jarodlam/surf-rescue-boat/report/vres-report.pdf

# Autonomous surf life saving device

## Jarod Lam

## Supervisor: Matthew Dunbabin

2018-2019 VRES project at Queensland University of Technology

CONTENTS

I | Introduction | 2
II | Boat | 2
II-A | Mechanical | | 2
II-A1 | Chassis | | 2
II-A2 | Propellors | | 2
II-A3 | Electronics housing | | 2
II-B | Electronics | | 2
II-B1 | Microcontroller | | 2
II-B2 | Radio | | 2
II-B3 | GPS | | 2
II-B4 | Orientation | | 3
II-B5 | Motor control | | 3
II-B6 | Battery | | 3
II-C | Software | | 3
II-C1 | srb | | | 3
II-C2 | nmea | | 3
II-C3 | srb_stats | | 3
II-C4 | srb_serial | | 3
II-C5 | srb_gps | | 3
II-C6 | srb_comms | | 3
II-C7 | srb_imu | | 3
II-C8 | srb_motor | | 3
II-C9 | srb_nav | | 3
III | Communications | 4
III-A | NMEA 0183 protocol | | 4
III-B | Proprietary NMEA sentences | | 4
III-B1 | SRBSM - Status Message . . | 4
III-B2 | SRBJS - Joystick | | 4
III-B3 | SRBWP - Waypoint | | 4
IV | Testing | 4
V | Future development | 4
References | 4
Appendix A: Code | | | 5
A-A | the codes | | 5
Appendix B: Drawings | | | 5
B-A | the drawings | | 5
Abstract—build boat that saves people
I. INTRODUCTION
Surf life savers regularly patrol popular beaches to help those in danger, but there is a limit to the speed and ability of a human swimmer.
To supplement the activities of surf life savers at public beaches, a system has been proposed that will allow timely help to be given to people in danger while they wait to be rescued. The surf rescue boat (SRB) aims to deliver help quickly and reduce the risk to which life savers are exposed. A simple water-based robot such as the one proposed can be constructed relatively cheaply and easily with off-the-shelf components. In the future, systems such as these may become widely available and save the lives of many along our coastal beaches. A prototype of one such robot was designed and built over the course of this project.
The system is divided into three main sections: a remotely operated water vehicle (the ”boat”), an XBee-based radio communications system and protocol, and shoreline control. Out of these, only the vehicle and communications were pro-totyped in this project; the control system has been developed separately in the past and time constraints prevented it from being implemented.
This report describes these systems in detail, the design methodology, and avenues that can be explored for future development of the surf rescue boat.

II. BOAT

A. Mechanical

The remotely operated boat uses a standard surfboard as a base, and houses electronics in a watertight hard plastic case attached to the top. Two propellers are mounted to the bottom of the surfboard for movement control.
1) Chassis: Surfboard. Chosen for its stability and familiar-ity in the surf. The standardness and availability of surfboards is an advantage to encouraging development of such systems. A custom-built chassis may have been designed, but would have taken more time and money.
2) Propellors: 2 Blue Robotics T100 Thrusters. A propeller is mounted each to the left and right of the surfboard’s middle underside. Aluminium mounting plates, attached to the board with Sikaflex, were designed to distribute force and allow propellors to be detached easily.
3) Electronics housing: Pelican 1120 Case. A laser-cut acrylic frame was made to mount the electronics in the box. Wire glands on the side of the box allow propellor wires to be fed through the box walls.
B. Electronics

An Arduino Mega 2560 controls the onboard electronics mounted in the case. GPS and IMU modules are used for navigation, and an XBee radio communicates with the base station. A block connection diagram of the electronics is shown in Figure 1.
1) Microcontroller: Arduino Mega 2560 with Seeedstudio Grove Mega Shield breakout board. This development board is powerful enough to handle relatively simple communication and processing tasks required to control the boat’s sensors and motors. More powerful ARM-based boards such as the Raspberry Pi are less suited to rugged environments, and more difficult to recover from failures. The shield provides robust headers to the UART functions of the Arduino.
2) Radio: Digi XBee Pro S1 on a SparkFun XBee Explorer Regulated. This connects to the Arduino via UART, and creates a wireless serial connection to the base station. The protocol is defined in section 3.
3) GPS: LOCOSYS LS20031 GPS receiver. Sends data to the Arduino via UART using the NMEA 0183 protocol found in section 3.

11.1V

UART
UART

UART

PWM

Arduino Mega

Battery 1

Battery 2

ESC 1

ESC 2

XBee

GPS | IMU

Fig. 1. Connection block diagram for onboard electronics.

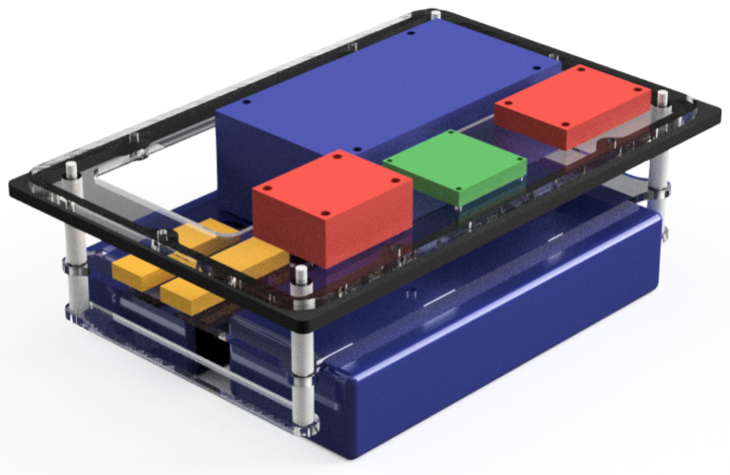
[picture p9: figure]

Fig. 2. Rendering of internal electronics frame

4) Orientation: Sparkfun SEN-10736 9DOF Razor IMU. Sends data to the Arduino via UART. Currently, only the compass value from the sensor is used. Flashed with the Razor AHRS firmware: https://github.com/Razor-AHRS/razor-9dof-ahrs
5) Motor control: 2 Flycolor Raptor 390 30A ESC. Firmware modified to allow forward and backward propeller movement. Receives PWM control signals from the Arduino with a duty cycle range of 1000 µs to 2000 µs.
6) Battery: 2 Zippy Flightmax Z58003S-30 5800 mAh 3S1P. The two batteries are wired in parallel, with a combined nominal capacity of 11.6 Ah and nominal voltage of 11.1 V.
C. Software
The Arduino Mega 2560 is programmed in C++ on top of Arduino default and custom libraries. Efforts were made to keep the code somewhat portable and reusable.
The code is split up into several modules, each handling a section of robot operation. These are described below, and the full code can be found in appendix A.
1) srb: Contains the main loop of the program. Initialises values, classes, etc. Runs update functions for GPS, comms, IMU, nav, and motors. Sends SRBSM message at intervals. An AVR watchdog timer is set to reset the microcontroller at the hardware level if the program hangs and reaches a timeout.
2) nmea: Defines the Nmea class, which contains functions for constructing and parsing NMEA 0183 sentences. This includes generating and validating checksums, counting the number of fields, appending strings and decimal numbers to a sentence, and parsing a sentence by field. All functions use standard C string libraries, so they do not rely on Arduino libraries and will work outside the Arduino environment. Used
by SrbGps and SrbComms.
3) srb_stats: Defines the SrbStats class, which stores the ID, state, GPS and target location, compass and target heading, and other information related to the current state and navigation of the boat. A pointer to the same instance of this class is passed to most other classes when they are created so that they can read and update this information.
4) srb_serial: Defines the SrbSerial class, which buffers a hardware serial stream and parses the input when a newline is received. The serial port used is configured when the object is created. This is the base class for SrbGps,
SrbComms, and SrbImu.
5) srb_gps: Defines the SrbGps class, which receives and parses GPS fix data over serial. Latitude, longitude, magnetic variation, and ground speed are parsed from the NMEA GPRMC sentence and stored in the SrbStats object. Conversions are made from knots to metres per second, and degrees/minutes to decimal degrees.
6) srb_comms: Defines the SrbComms class, which sends and receives messages to and from the base station via the XBee radio. Contains functions for constructing and parsing the proprietary NMEA sentences defined in section 3. Stores information and instructions received in the SrbStats object. Stops the boat if no message is received within a timeout period.
7) srb_imu: Defines the SrbImu class, which receives data from the Sparkfun IMU over serial. Extracts the compass heading from the serial stream and stores it in the SrbStats object.
8) srb_motor: Defines the SrbMotor class, which controls motor movement. Receives motor power ranges from -100 to 100 and sets the corresponding PWM duty cycle. Accelerates motors to the desired speed at a safe pace.
9) srb_nav: Defines the SrbNav class, which controls robot navigation. In manual mode, sets motor speed and orients the boat according to target speed and heading sent from the base station. In auto mode, moves the boat toward a set of coordinates sent from the base station. Motors are controlled with the SrbMotor class.

III. COMMUNICATIONS

Communications between the SRB and the base station are done using XBee radios. By attaching a pair of XBee modules to the base station computer and the on-board Arduino, a virtual serial connection is effectively created between the two devices.

A. NMEA 0183 protocol

NMEA 0183 is a communications specification designed to create a standardised serial interface for GPS devices. Every NMEA ‘sentence’ begins with a $ and ends with *CS\r\n, where CS is a two-digit hexadecimal checksum of the sentence.
A common NMEA sentence type is GPRMC, the GPS recommended minimum. GPRMC sentences are specified as follows: [1]

$GPRMC,<Time>,<Status>,<Lat>,<LatDir>, <Lon>,<LonDir>,<Speed>,<Angle>,<Date>, <MagVar>,<MagDir>*CS

Where:
<Time> | UTC timestamp in HHmmss format
<Status> | Status A=active, V=void
<Lat> | Latitude in ddmm.mmm format
<LatDir> | N or S hemisphere
<Lon> | Longitude in dddmm.mmm format
<LonDir> | E or W hemisphere
<Speed> | Ground speed in knots
<Angle> | Track angle in degrees from north
<Date> | Date in DDMMYY format
<MagVar> | Magnetic variation magnitude
<MagDir> | Magnetic variation direction

A NMEA sentence parser was written for the SRB to interpret messages from the on-board GPS and extract location information.

B. Proprietary NMEA sentences

Some advantages of using NMEA sentences are that they are standardised, human-readable, robust, and relatively simple to implement. Specified below is a set of custom NMEA sentence types was created for communication between the boat and the base station.

1) SRBSM - Status Message: The SRBSM sentence is sent periodically by the boat to update the base station with status information.

$SRBSM,<ID>,<State>,<Lat>,<Lon>,<Speed>, <Heading>,<BattV>,<FwdPower>, <TgtHeading>*CS

Where:

<ID> | ID of target SRB
<State> | 0=disabled, 1=manual, 2=auto
<Lat> | Latitude in decimal degrees
<Lon> | Longitude in decimal degrees
<Speed> | Speed in metres per second
<Heading> | Compass heading in degrees CW from north
<BattV> | Current battery voltage
<FwdPower> | Forward power from -100 to 100
<TgtLat> | Target latitude in decimal degrees
<TgtLon> | Target longitude in decimal degrees
<TgtHeading> | Target heading in degrees CW from north
2) SRBJS - Joystick: The SRBJS sentence is sent by the base station for manual control of the boat.

$SRBJS,<ID>,<FwdPower>,<TgtHeading>*CS

Where:
<ID> | ID of target SRB
<FwdPower> | Forward power from -100 to 100
<TgtHeading> | Target heading in degrees CW from north
3) SRBWP - Waypoint: The SRBWP sentence is sent by the base station to autonomously direct the boat to a set of coordinates.

$SRBJS,<ID>,<TgtLat>,<TgtLon>*CS

Where:
<ID> | ID of target SRB
<TgtLat> | Target latitude in decimal degrees
<TgtLon> | Target longitude in decimal degrees

IV. TESTING

V. FUTURE DEVELOPMENT

REFERENCES

[1] D. DePriest, “Nmea data,” accessed November 2018. [Online]. Available: https://www.gpsinformation.org/dale/nmea.htm

APPENDIX

A
CODE
A. the codes

APPENDIX

B
DRAWINGS
A. the drawings
