jarodlam/surf-rescue-boat/presentation/vres-presentation.pdf

# Autonomous surf life saving device

# I like boats

Jarod Lam (QUT) | Autonomous surf life saving device | 13th February 2019 | 1 / 1
