jarodlam/surf-rescue-boat/CAD/srb-top-board_ACR-3mm.dxf

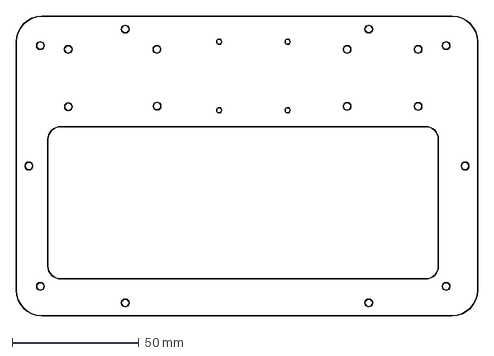
[picture p10: CAD file, 2019-02-09]
CAD/srb-top-board_ACR-3mm.dxf
182.0 x 118.0 mm
