jarodlam/surf-rescue-boat/CAD/srb-middle-board_ACR-3mm.dxf

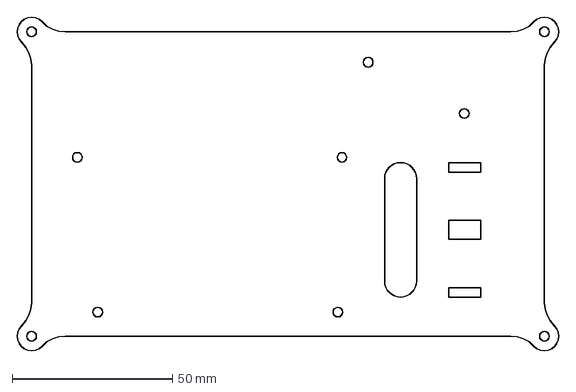
[picture p11: CAD file, 2019-02-09]
CAD/srb-middle-board_ACR-3mm.dxf
169.5 x 104.5 mm
