jarodlam/surf-rescue-boat/CAD/srb-bottom-board_ACR-3mm.dxf

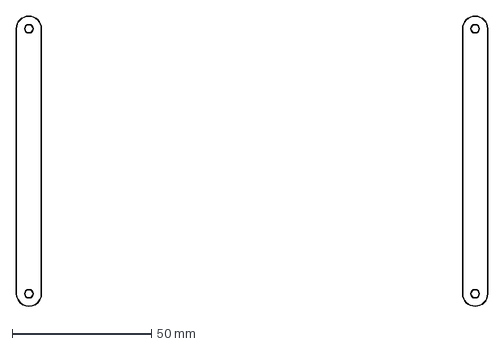
[picture p12: CAD file, 2019-02-09]
CAD/srb-bottom-board_ACR-3mm.dxf
169.0 x 104.2 mm
