jarodlam/surf-rescue-boat/CAD/srb-motor-mount-top_ALU-3mm.dxf

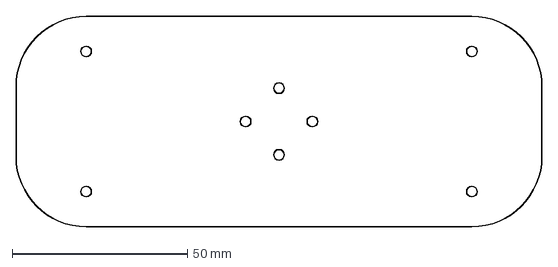
[picture p13: CAD file, 2019-01-14]
CAD/srb-motor-mount-top_ALU-3mm.dxf
150.0 x 60.0 mm
