jarodlam/surf-rescue-boat/CAD/srb-motor-mount-bottom_ALU-8mm.dxf

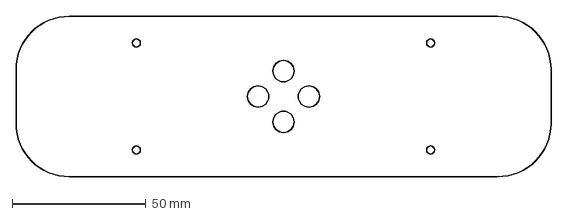
[picture p14: CAD file, 2019-01-14]
CAD/srb-motor-mount-bottom_ALU-8mm.dxf
200.0 x 60.0 mm
