jarodlam/surf-rescue-boat/vres-report/bottom-board-drawing.pdf

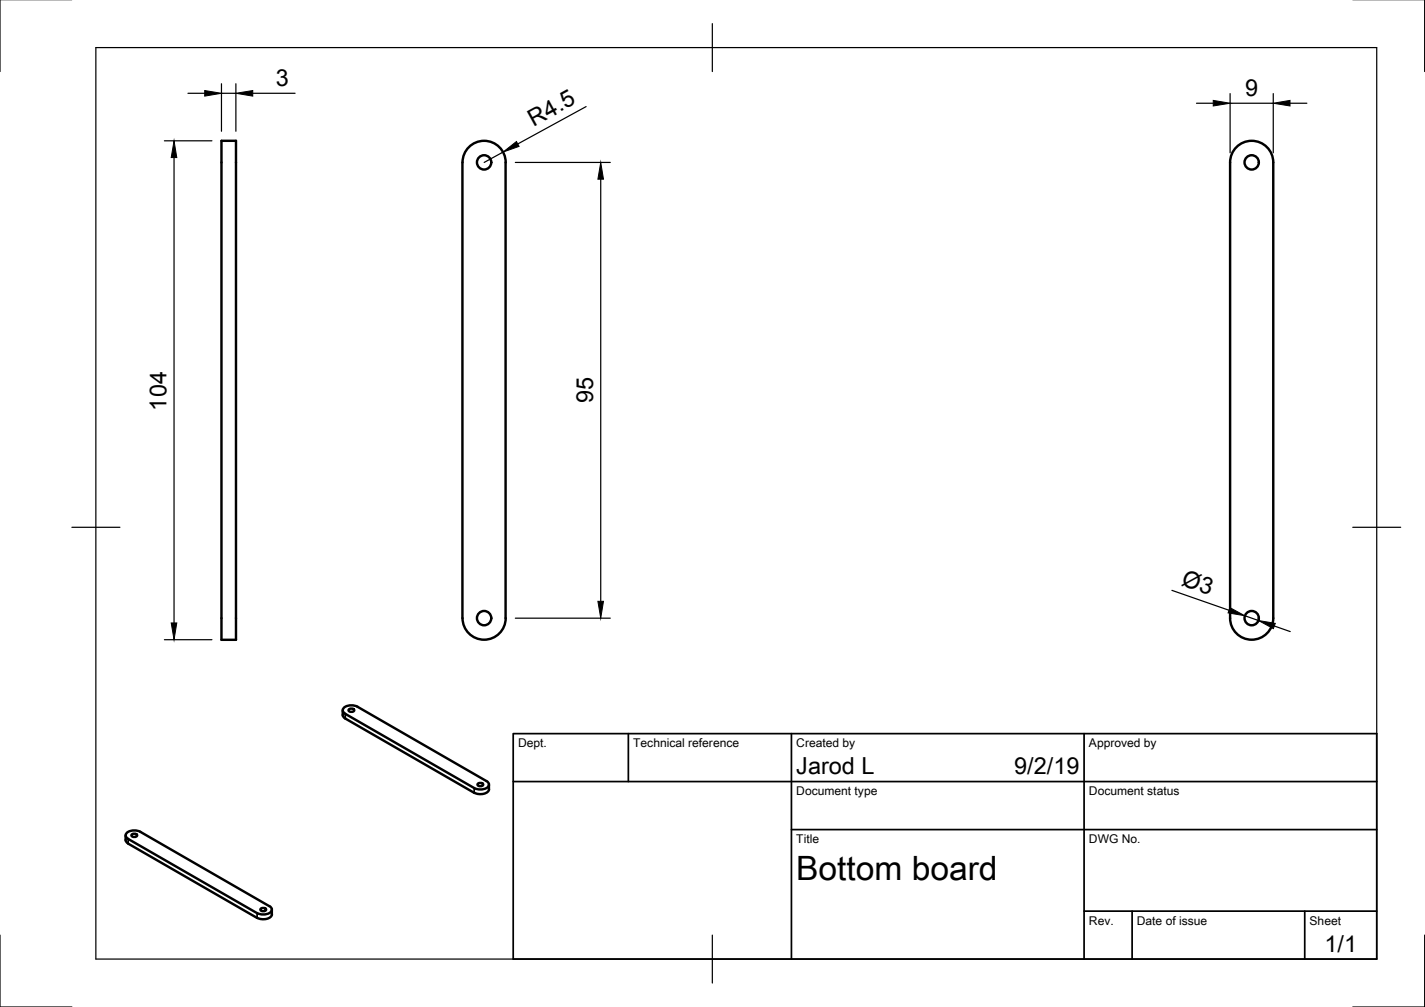
[picture p15: page 1]

Dept. | Technical reference | Created by Jarod L 9/2/19 | Approved by

Document type | Document status

Title Bottom board | DWG No.

Rev. | Date of issue | Sheet 1/1
