jarodlam/surf-rescue-boat/vres-report/middle-board-drawing.pdf

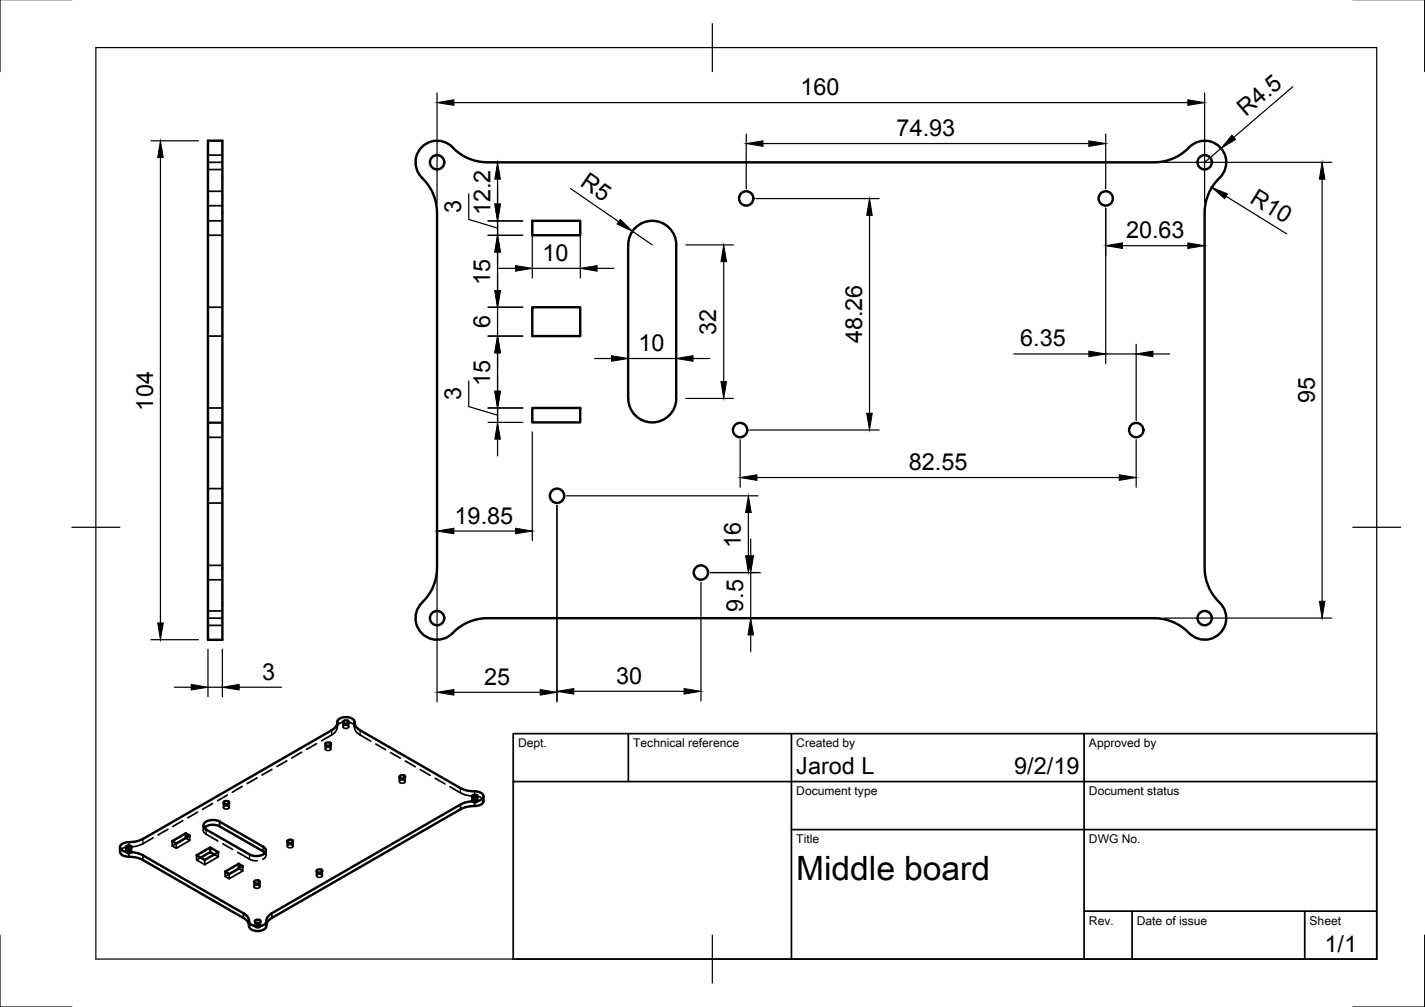
[picture p16: page 1]
Jarod L 104

Dept. | Technical reference | Created by 9/2/19 | Approved by

Document type | Document status

Title Middle board | DWG No.

Rev. | Date of issue | Sheet 1/1
