jarodlam/surf-rescue-boat/vres-report/motor-mount-bottom-drawing.pdf

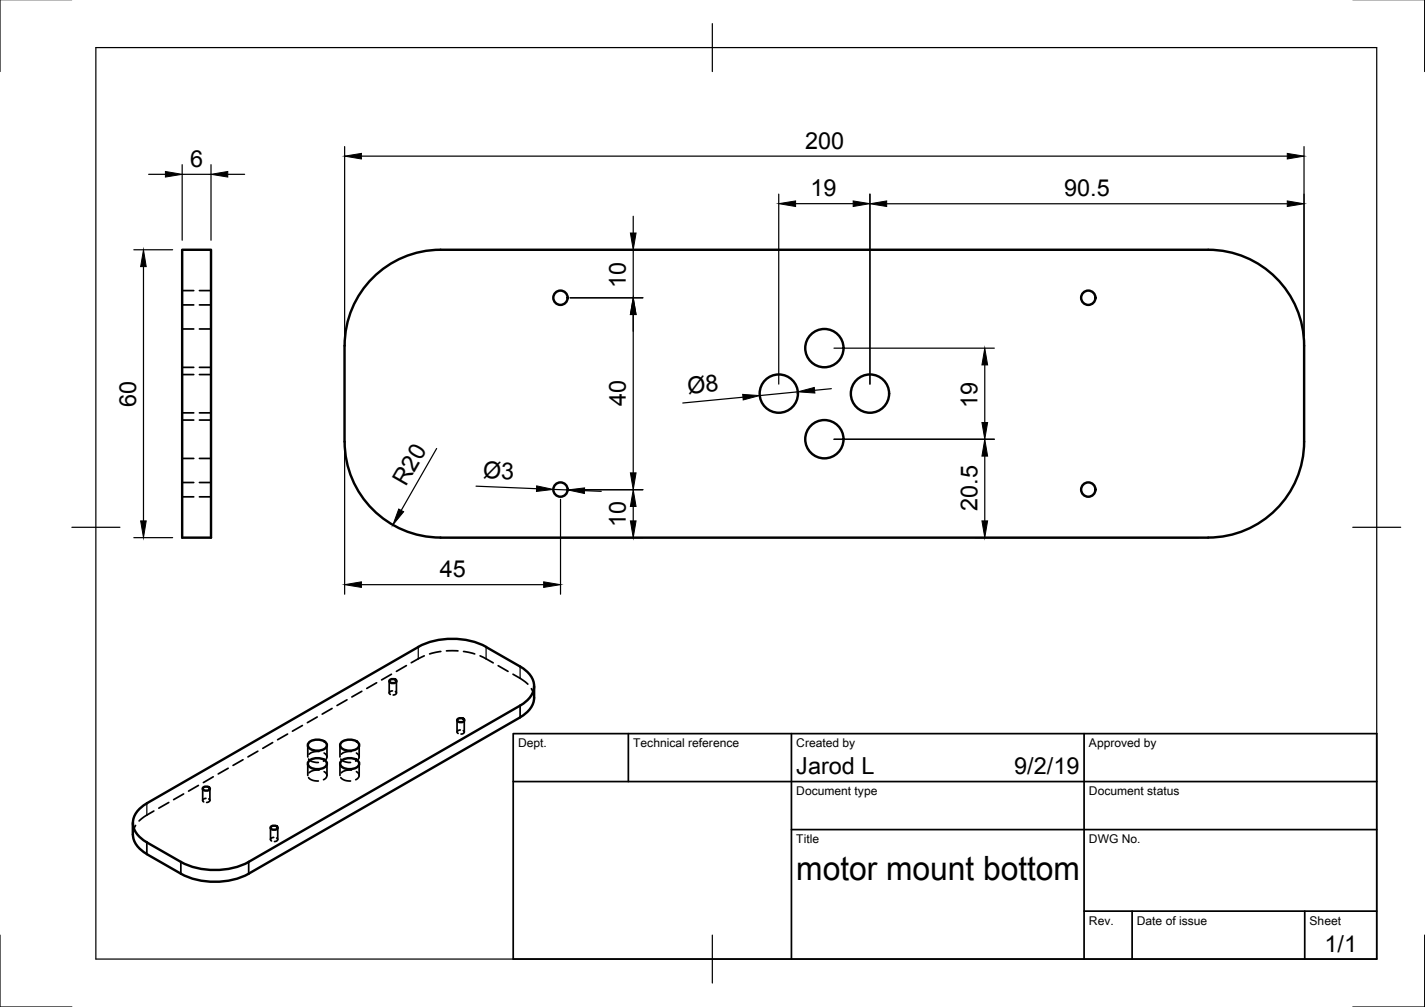
[picture p17: page 1]

Dept. | Technical reference | Created by Jarod L 9/2/19 | Approved by

Document type | Document status

Title motor mount bottom | DWG No.

Rev. | Date of issue | Sheet 1/1
