jarodlam/surf-rescue-boat/vres-report/motor-mount-top-drawing.pdf

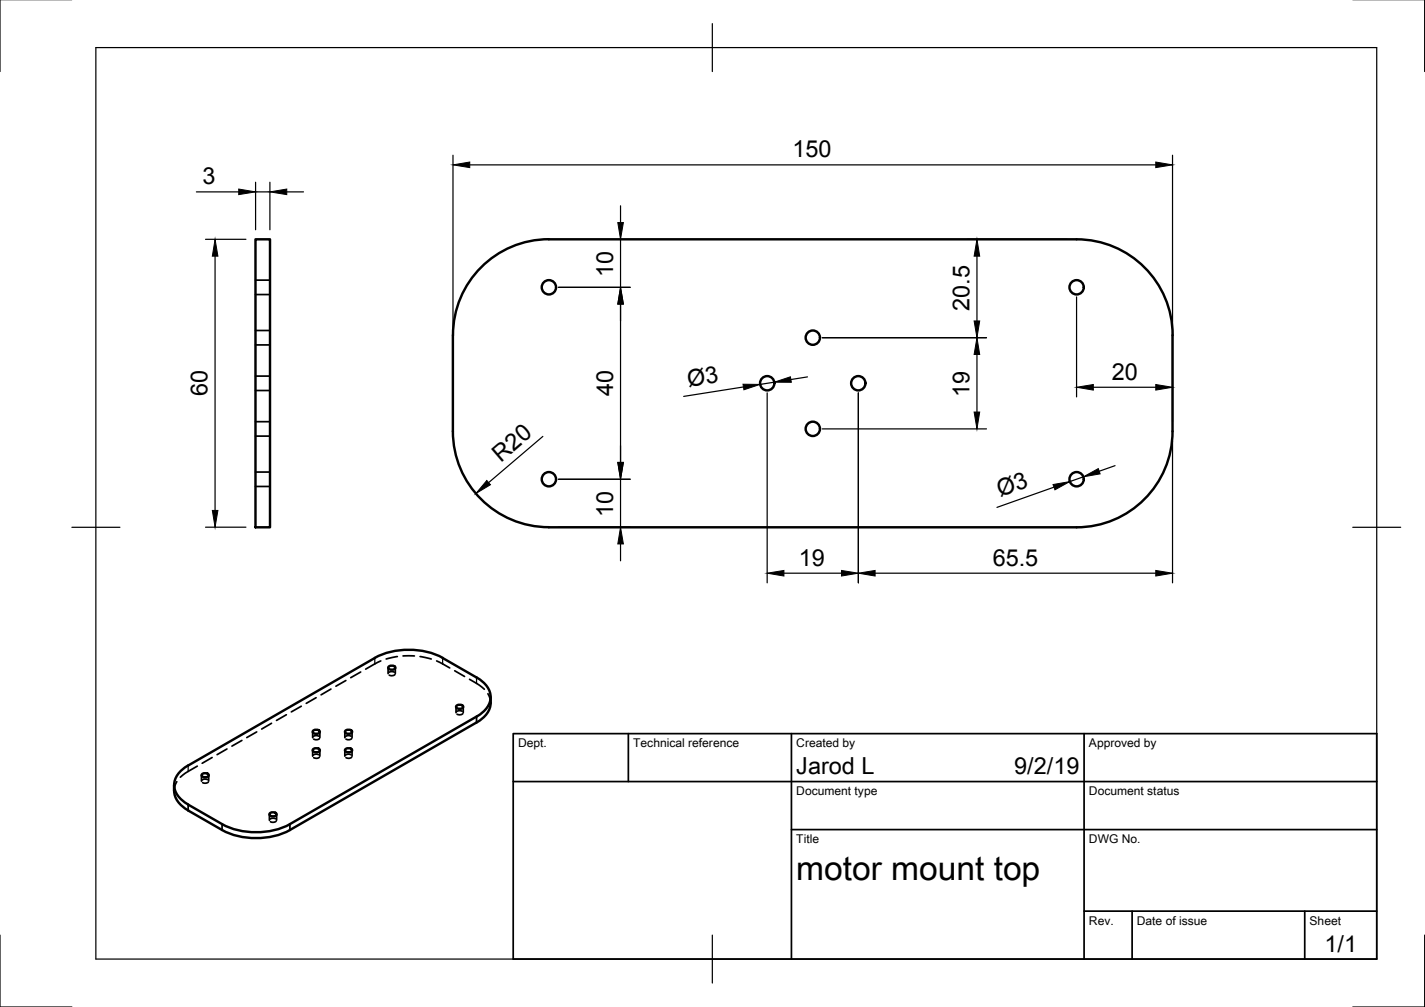
[picture p18: page 1]

Dept. | Technical reference | Created by Jarod L 9/2/19 | Approved by

Document type | Document status

Title motor mount top | DWG No.

Rev. | Date of issue | Sheet 1/1
