jarodlam/surf-rescue-boat/vres-report/top-board-drawing.pdf

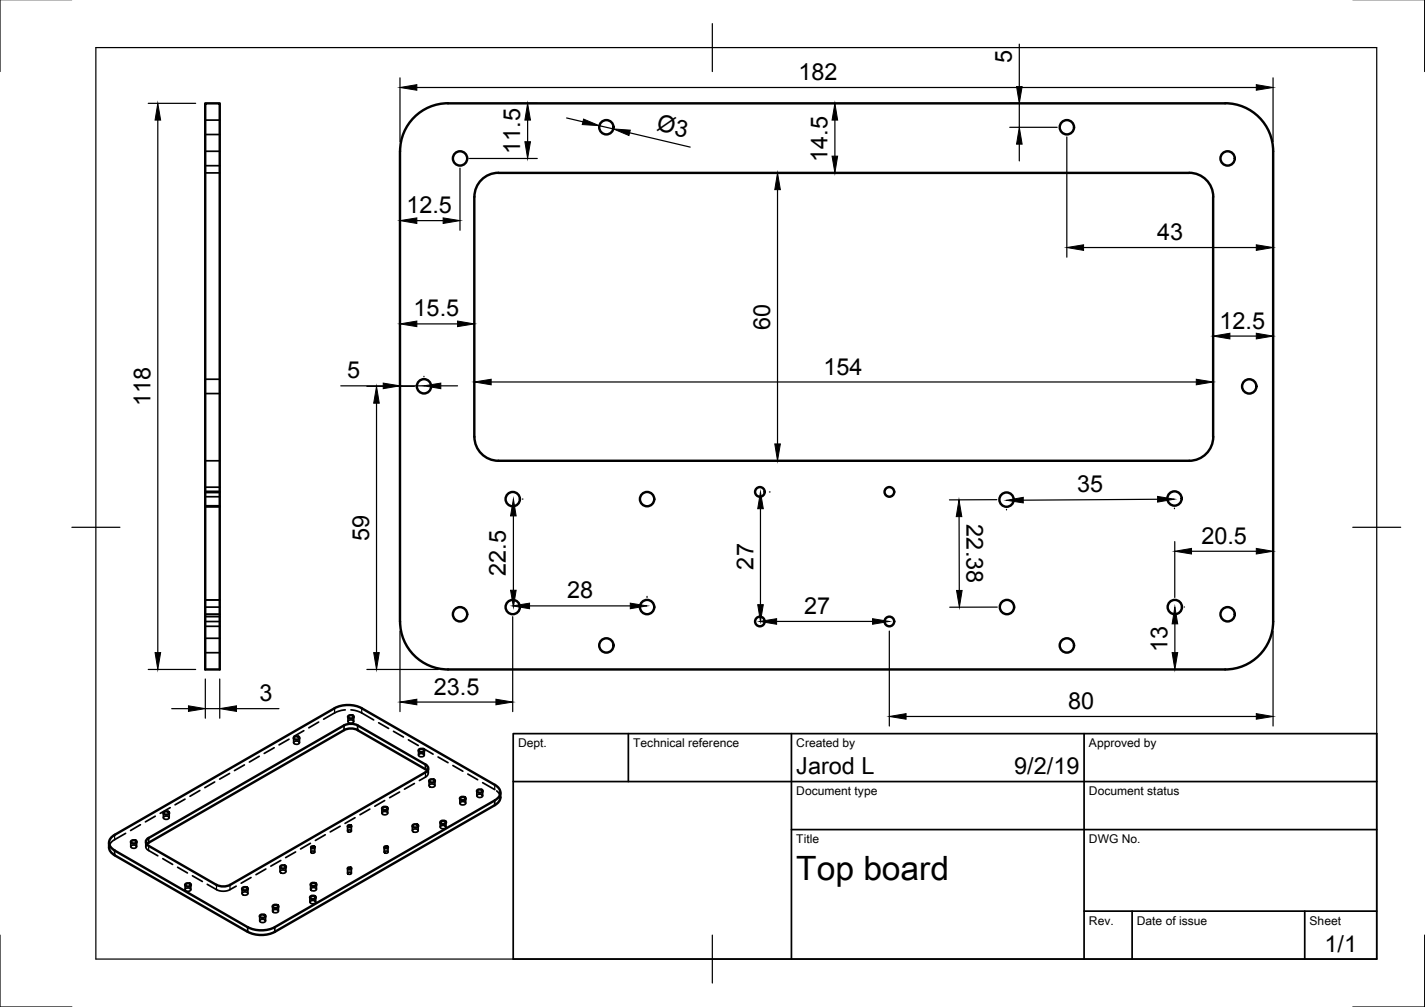
[picture p19: page 1]
Jarod L 118

Dept. | Technical reference | Created by 9/2/19 | Approved by

Document type | Document status

Title Top board | DWG No.

Rev. | Date of issue | Sheet 1/1
