jarodlam/surf-rescue-boat/srb/srb_serial.h

/*
   srb_serial.h
   General class for receiving data over serial
   Written by Jarod Lam
*/

#ifndef srb_serial_h
#define srb_serial_h

#define SERIAL_BUFFER_SIZE 1024
#define SERIAL_BUFFER_TIMEOUT 100

#include <Arduino.h>
#include "srb_stats.h"

class SrbSerial {

  public:

    /*
     * Initialise SrbImu with the IMU serial port.
     */
    explicit SrbSerial(SrbStats *stats, HardwareSerial *port, long baud);

    /*
     * Update the values from serial.
     */
    void update();

  protected:

    /*
     * Pointer to the XBee serial port object.
     */
    HardwareSerial *_serial;

    /*
     * Pointer to the stats object given at creation.
     */
    SrbStats *_stats;

    /*
     * Buffers for storing I/O data.
     */
    char _buffer[SERIAL_BUFFER_SIZE];
    unsigned long _bufferClearTime;
    void _clearBuffer();

    /*
     * Update buffer with new serial info.
     */
    void _updateSerial();

    /*
     * Parse the contents of the buffer after a carriage return.
     */
    virtual void _parseBuffer() {};
  
};

#endif
