jarodlam/surf-rescue-boat/(commit log)

2018-11-12 Arduino testing
2019-01-04 Add state and watchdog timer
2019-01-07 Failsafe timeout when connection lost
    [srb.ino, srb_comms.cpp, srb_comms.h]
2019-01-08 Fix library naming and ifndefs
    [nmea.cpp, nmea_gps.cpp, srb_comms.cpp]
2019-01-09 Rudimentary motor control
2019-01-10 Motor acceleration for safety
2019-01-11 Correct using radians for angle calculation
    [srb.h, srb_comms.cpp, srb_nav.cpp]
2019-01-14 Motor mount plates
    [srb-motor-mount-bottom_ALU-8mm.dxf, srb-motor-mount-top_ALU-3mm.dxf]
2019-01-16 Test electronics mounting board
    [srb-control-board_ACR-3mm.dxf]
2019-01-16 New improved motor power algorithm
2019-01-16 Remove failsafe timeout #ifdef
    [srb.h, srb.ino, srb_comms.cpp]
2019-01-17 Remove CAD
    [srb-control-board_ACR-3mm.dxf, srb-motor-mount-bottom_ALU-8mm.dxf, srb-motor-mount-top_ALU-3mm.dxf]
2019-02-05 Support for IMU
2019-02-05 Fix includes and rename srb_stats
    [nmea.cpp, nmea.h, srb.ino, srb_comms.cpp, srb_comms.h, srb_gps.cpp, srb_gps.h, srb_imu.cpp]
2019-02-09 Add CAD files and drawings
    [srb-bottom-board_ACR-3mm.dxf, srb-middle-board_ACR-3mm.dxf, srb-motor-mount-bottom_ALU-8mm.dxf, srb-motor-mount-top_ALU-3mm.dxf, srb-top-board_ACR-3mm.dxf]
2019-02-12 Changes to ESC arming
2019-03-09 Tweaks to motor init
